johonkanen/ac_inout_power_supply_docs/README.rst

Documentation pages for an FPGA controlled power supply
=======================================================

See code at https://github.com/johonkanen/ac_in_ac_out_lab_power_supply

Pages are found at 
https://ac_inout_power_supply_docs.readthedocs.io
