johonkanen/ac_inout_power_supply_docs/20220806_163628.jpg

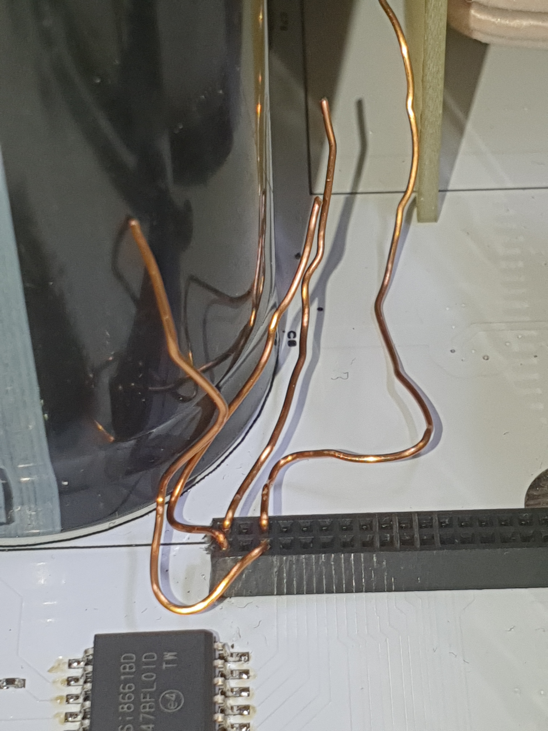
20220806_163628.jpg
