johonkanen/ac_inout_power_supply_docs/20220816_195157.jpg

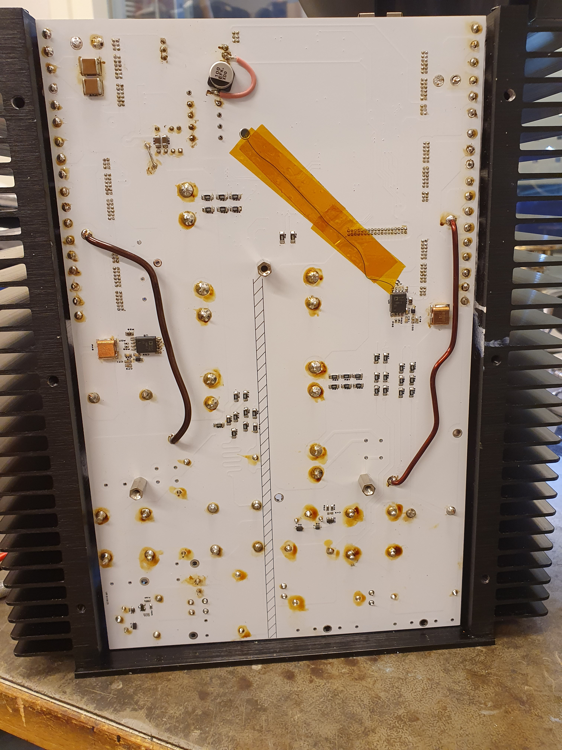
20220816_195157.jpg
