johonkanen/ac_inout_power_supply_docs/(list of files, drawings)

Other design files:
pcb_files/gate_driver/gate_drive_power_asym_fb_v3_ee10.pdsprj
pcb_files/power_card/single_phase_inverter_psu.pdsprj
pcb_files/psu_control_card/psu_control_card_v1.pdsprj
