johonkanen/ac_inout_power_supply_docs/(commit log)

2022-08-10 add more explanation on the gate power supply
2022-08-13 add pictures to gate powers
2022-08-13 add notes for gate drive powers
2022-08-14 add pcb files to project documents
    [gate_drive_power_asym_fb_v3_ee10.pdsprj, psu_control_card_v1.pdsprj, single_phase_inverter_psu.pdsprj]
2022-08-14 add note about how to view schematics
