johonkanen/ac_inout_power_supply_docs/20220811_182755.jpg

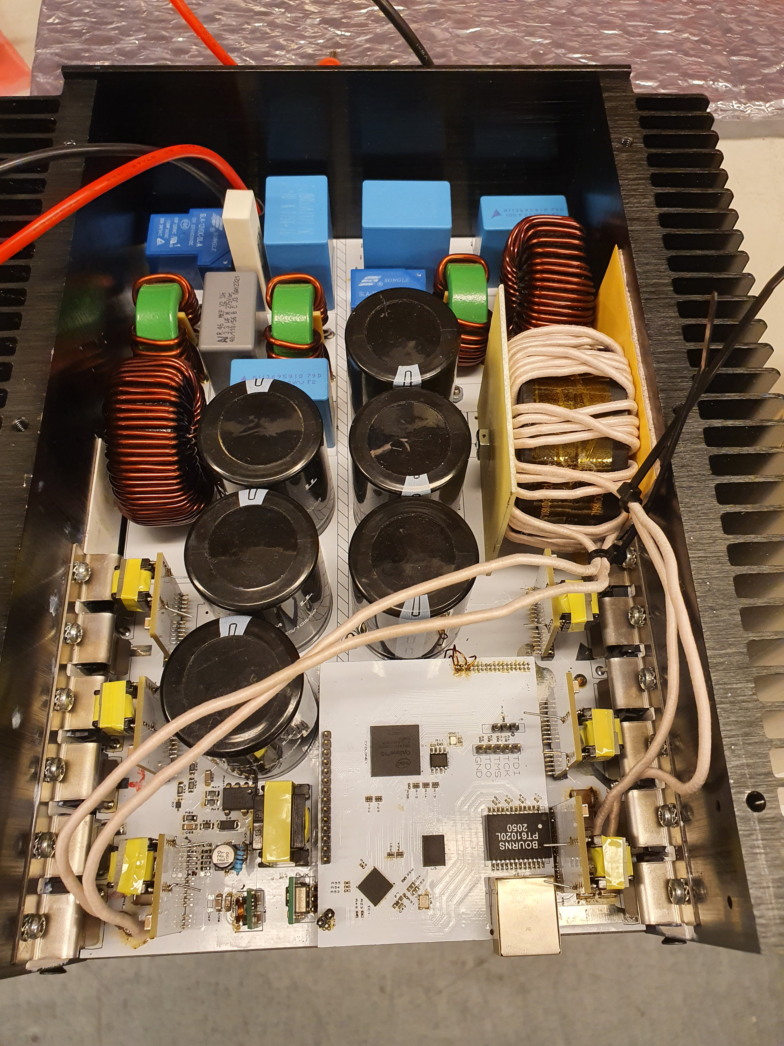
[picture p1: 20220811_182755.jpg]
20220811_182755.jpg
