johonkanen/ac_inout_power_supply_docs/20220803_195351.jpg

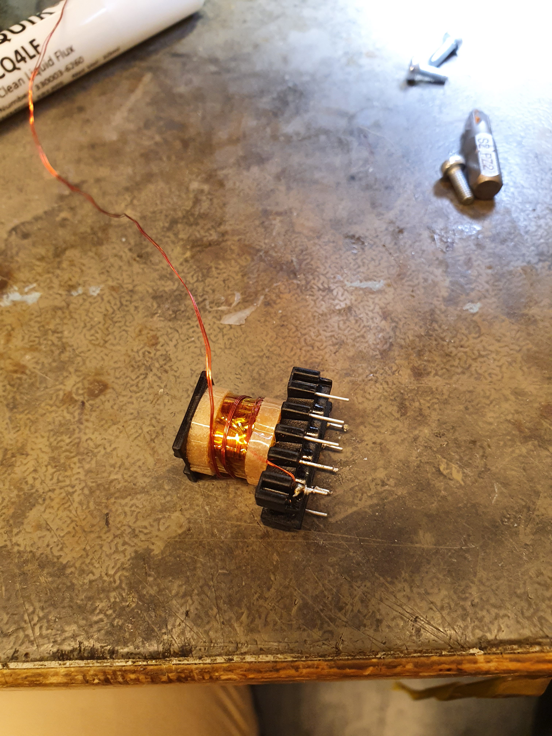
[picture p2: 20220803_195351.jpg]
20220803_195351.jpg
