johonkanen/ac_inout_power_supply_docs/gate_power_transformer_build.jpg

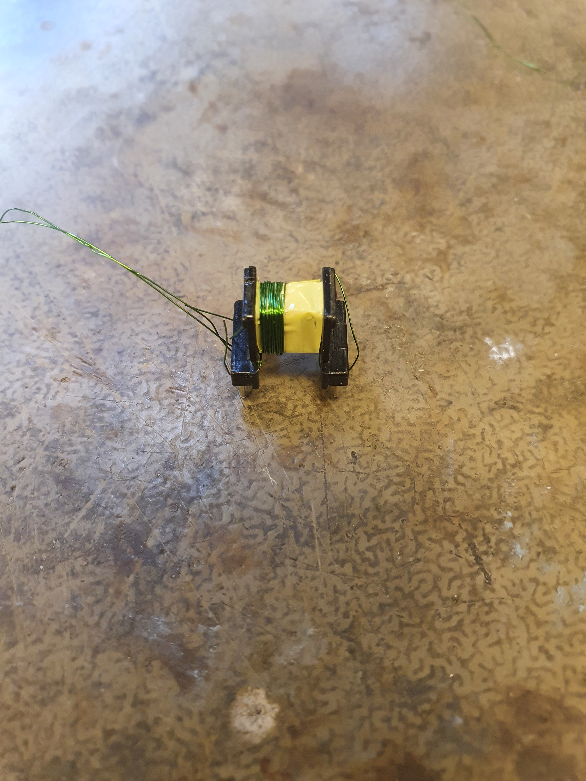
[picture p4: gate_power_transformer_build.jpg]
gate_power_transformer_build.jpg
