johonkanen/ac_inout_power_supply_docs/20220823_084754.jpg

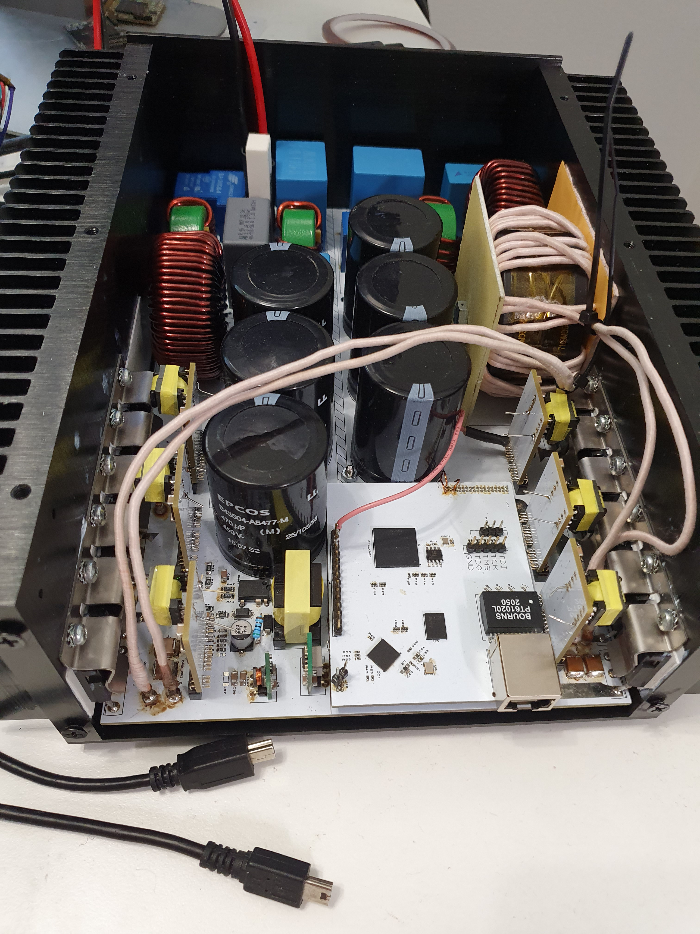
20220823_084754.jpg
