johonkanen/ac_inout_power_supply_docs/full_picture.jpg

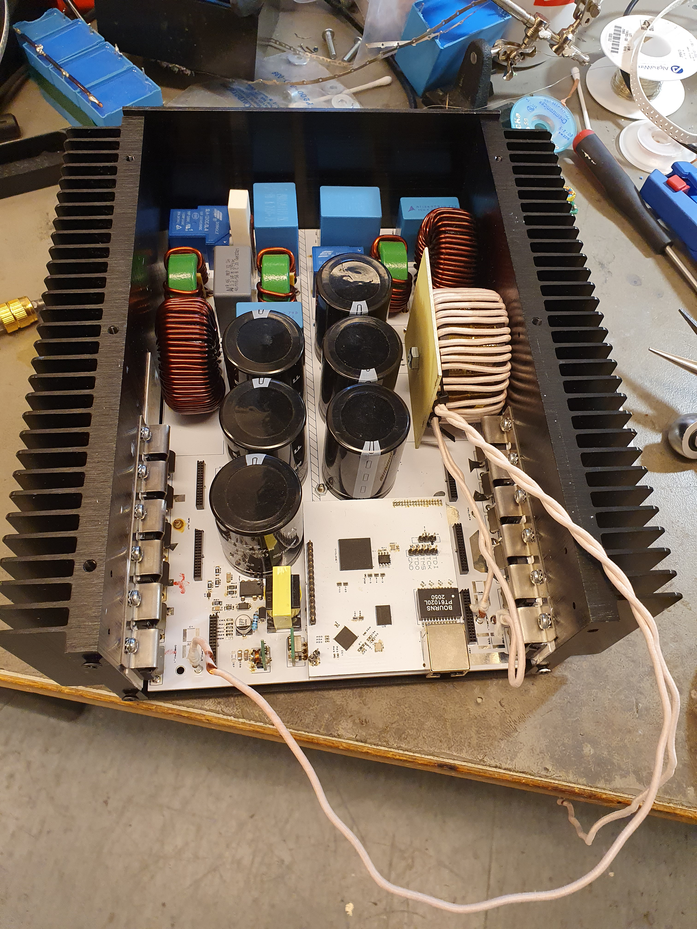
full_picture.jpg
